shizhuozhang/17_eletricity_simu_platform-YkZ/README.md

该项目针对电力仿真实验平台设计底层信息采集电路和处理程序，然后将其发送到PC端的上位机进行不同模式的电力仿真实验。

感兴趣的同学想要进一步了解项目详情，请联系我：yaokunz@hust.edu.cn
