shizhuozhang/17_eletricity_simu_platform-YkZ/DOC/电气实验平台元件清单V2.0.xlsx

实验台元件清单
 | 元件名 | 数量 | 单价 | 备注 | 购买链接 | 总价
面板上器件 | 圆形带灯自锁按钮 | 17 | 3.2 | 灯珠额定电压12V，红色 | https://item.taobao.com/item.htm?spm=a1z09.2.0.0.2ed6e7970VER5y&id=554540313597&_u=p22lrpv0edf0 | 54.4
 | 圆形带灯自复位按钮 | 2 | 2.8 | 灯珠额定电压12V，绿色 | https://item.taobao.com/item.htm?spm=a1z09.2.0.0.2ed6e7970VER5y&id=554540569113&_u=p22lrpv05211 | 5.6
 | 桌面开关 | 1 | 16.5 | 蓝色灯 | https://item.taobao.com/item.htm?spm=a1z09.2.0.0.rZ6yvK&id=526487132607&_u=tk5ocd0355b | 16.5
 | 八档转换开关 | 1 | 24 |  | https://item.taobao.com/item.htm?id=35778651608&_u=t2dmg8j26111 | 24
 | 4位数码管显示模块 | 4 | 18 |  | https://item.taobao.com/item.htm?id=38198078596&_u=t2dmg8j26111 | 72
 | 单圈线绕电位器 | 4 | 9.9 | 2K | https://item.taobao.com/item.htm?spm=a1z0d.6639537.1997196601.68.4b6215db5HO0gG&id=548292367332 | 39.6
 | 闪光蜂鸣器 | 1 | 3.3 |  | https://item.taobao.com/item.htm?spm=a1z09.2.0.0.rZ6yvK&id=4427723937&_u=tk5ocd0a434 | 3.3
 | PCB测试环 | 1 | 5.8 | 5.8是50个的总价 | https://detail.tmall.com/item.htm?id=528363218937&cm_id=140105335569ed55e27b&abbucket=10 | 5.8 | 没找到可替代的
 | 无线鼠标键盘 | 1 | 89 | 大致选了一个 | https://detail.tmall.com/item.htm?id=527056303716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 | 89
 | WIFI模块 | 1 | 146 |  | https://item.taobao.com/item.htm?id=35679630030&ns=1&abbucket=10 | 146
 | 双组开关电源 | 1 | 42 | 5V 3A/ 12V 2A | https://item.taobao.com/item.htm?id=522984722760 | 42
 | 小型断路器 | 1 | 0 | 2P，10A | https://detail.tmall.com/item.htm?id=16148926870&ns=1&abbucket=10&skuId=3427223401384 | 0 | 不知道需不需要
 | 插座 | 1 | 19.2 | 五孔 | https://detail.tmall.com/item.htm?id=524785657239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 | 19.2
硬件电路器件， 包括：（1）电源部分，（2）电气连接端子与线材，（3）PCB焊接元件 | 红黑排线 | 1 | 1.25 | 0.5平 | https://item.taobao.com/item.htm?id=38043211218&ns=1&abbucket=10 (https://item.taobao.com/item.htm?spm=a230r.1.14.55.76bf523JzRB5x&id=38043211218&ns=1&abbucket=10) | 1.25
 | 直针XH2.54端子（一套10个） | 1 | 0.3 | 3P | https://item.taobao.com/item.htm?spm=a1z09.2.0.0.2ed6e797TqQxSN&id=35551070467&_u=p22lrpv0304e | 0.3
 | 弯针XH2.54端子（一套10个） | 4 | 0.45 | 3P | https://item.taobao.com/item.htm?spm=a1z09.2.0.0.2ed6e797TqQxSN&id=35551605817&_u=p22lrpv0c882 | 1.8
 |  | 1 | 0.6 | 4P |  | 0.6
 |  | 1 | 0.75 | 5P |  | 0.75
 |  | 1 | 1.2 | 8P |  | 1.2
 |  | 1 | 1.35 | 9P |  | 1.35
 |  | 1 | 1.8 | 12P |  | 1.8
 | CH5.08接插件（一套10个） | 1 | 5.4 | 3P | https://item.taobao.com/item.htm?spm=a1z09.2.0.0.2ed6e797TqQxSN&id=16385186135&_u=p22lrpv0aaef | 5.4
 | CH5.08连接线3条 | 1 | 1.5 | 500MM | https://item.taobao.com/item.htm?spm=a1z09.2.0.0.2ed6e797TqQxSN&id=538319533713&_u=p22lrpv03020 | 1.5
 | KF2510接插件（一套20个） | 1 | 3 | 5P | https://item.taobao.com/item.htm?spm=a1z09.2.0.0.2ed6e797TqQxSN&id=16731699371&_u=p22lrpv0a187 | 3
 | 排针（一套10个） | 1 | 2 | 黄色,红色 | https://item.taobao.com/item.htm?spm=a1z09.2.0.0.2ed6e797TqQxSN&id=41359654622&_u=p22lrpv0bc8a | 2
 | KF2EDG 5.08接线端子（一套10个） | 1 | 4 | 直针 | https://item.taobao.com/item.htm?spm=a1z10.3-c-s.w4002-15103074458.33.6f79c998DQUeKp&id=543449267090 | 4
 | XH2.54连接线（26AWG,30CM |  |  | 3P单头
 | XH2.54连接线（26AWG,40CM | 4 | 0.5 | 3P单头 | https://item.taobao.com/item.htm?spm=a1z09.2.0.0.2ed6e797TqQxSN&id=550188224405&_u=p22lrpv0087b | 2
 |  | 1 | 0.8 | 5P单头 |  | 0.8
 |  | 1 |  |  |  | 0
 |  | 4 | 2.2 | 8P双头同向 |  | 8.8
 |  | 1 | 3 | 12P双头同向 |  | 3
 | XH2.54连接线（26AWG,50CM | 1 | 1.5 | 9P单头 |  | 1.5
 | KF2510连接线 (20CM) | 1 |  | 5P双头同向
 | KF2510连接线 (40CM) | 3 | 3 | 5P双头同向 | https://item.taobao.com/item.htm?spm=a1z09.2.0.0.2ed6e797TqQxSN&id=550188224405&_u=p22lrpv0087b | 9
 | IC插座（一套10个） | 1 | 1.2 | 16P | https://item.taobao.com/item.htm?spm=a1z10.3-c-s.w4002-15103074458.25.6f79c998Q06434&id=540234155161 | 1.2
 |  | 1 | 0.5 | 8P | https://item.taobao.com/item.htm?spm=a1z10.3-c-s.w4002-15103074458.28.6f79c998Q06434&id=540234067024 | 0.5
 | 主控电路板 | 1 | 8.1 | 10块样板81（含运费25） | http://www.sz-jlc.com/consumer/index.do;jsessionid=55A6A83F0942F5DDA84336B988B8CC49?s=1480256400475 | 8.1
 | 外围器件接口电路板 | 1 | 10.7 | 10块样板107（含运费17） |  | 10.7
 | MINI-USB数据线 | 1 | 3.5 | USB公头转MINI公头 | https://detail.tmall.com/item.htm?id=19648206353&rn=a4a52827b535e203981fcef212ce10ca&abbucket=6 | 3.5
 | MINI-USB插头 | 1 | 0.375 |  | https://detail.tmall.com/item.htm?id=18403110644&rn=a4a52827b535e203981fcef212ce10ca&abbucket=6 | 0.375
 | STM32F103RCT6芯片 | 1 | 19.6 | LQFT-64封装 | https://item.taobao.com/item.htm?spm=a1z09.2.0.0.2ed6e797TqQxSN&id=523892305756&_u=p22lrpv0c967 | 19.6
 | TLC5615，10位数模转换芯片 | 4 | 5 | DIP封装 | https://detail.tmall.com/item.htm?id=25890496045&spm=a1z09.2.0.0.2ed6e797TqQxSN&_u=p22lrpv099e3 | 20
 | 74HC165芯片 | 4 | 0.95 | DIP封装 | https://detail.tmall.com/item.htm?id=39693581268&spm=a1z09.2.0.0.2ed6e797TqQxSN&_u=p22lrpv0381c | 3.8
 | LM358双路运放 | 2 | 1 | DIP封装 | http://www.szlcsc.com/product/details_5634.html | 2
 | CH340C芯片 | 1 | 2.02 | SOP16封装 | http://www.szlcsc.com/product/details_85852.html | 2.02
 | P785光耦 | 1 | 0.42 | DIP封装 | https://item.taobao.com/item.htm?id=522578352711&ns=1&abbucket=10 (https://item.taobao.com/item.htm?spm=a230r.1.14.48.76bf523YAApDt&id=522578352711&ns=1&abbucket=10) | 0.42
 | AMS1117-3.3稳压芯片 | 4 | 0.7 | SOT-223封装 | http://www.szlcsc.com/product/details_6652.html | 2.8
 | HK19F-DC5V八脚继电器 | 1 | 2 |  | https://item.taobao.com/item.htm?spm=a1z09.2.0.0.2ed6e797TqQxSN&id=524178551384&_u=p22lrpv0a368 | 2
 | 直插无源石英晶振8M | 1 | 0.2 |  | https://detail.tmall.com/item.htm?id=25022680758&spm=a1z09.2.0.0.2ed6e797TqQxSN&_u=p22lrpv0e6fc | 0.2
 | 直插无源石英晶振12M | 1 | 0.2 |  |  | 0.2
 | 四脚贴片按键 | 1 | 0.07 |  | https://detail.tmall.com/item.htm?id=22247079909&rn=c54d9132209704ca52bad2cfbac3d2ca&abbucket=6 | 0.07
 | 自恢复保险丝8V/2.6A | 3 | 0.3 |  | https://detail.tmall.com/item.htm?id=18419209233&spm=a1z09.2.0.0.2ed6e797TqQxSN&_u=p22lrpv0dc97 | 0.9
 | 自恢复保险丝6V/0.5A | 2 | 0.24 |  | https://detail.tmall.com/item.htm?id=25039188105&spm=a1z09.2.0.0.2ed6e797xzGEqp&_u=p22lrpv0478b | 0.48
 | 贴片稳压二极管MM3Z3V3 | 30 | 0.06 |  | https://detail.tmall.com/item.htm?id=21781315853&spm=a1z09.2.0.0.2ed6e797TqQxSN&_u=p22lrpv03b83 | 1.8
 | TVS静电保护二极管3.3V | 3 | 0.15 |  | https://detail.tmall.com/item.htm?id=18423545093&spm=a1z09.2.0.0.2ed6e797xzGEqp&_u=p22lrpv02898 | 0.45
 | 贴片三极管S8050 | 1 | 0.35 |  | https://item.taobao.com/item.htm?spm=a1z10.3-c-s.w4002-16569462289.11.6f79c998pNWokU&id=522577964105 | 0.35
 | 贴片电感10UH | 2 | 0.05 |  | https://detail.tmall.com/item.htm?id=37616915845&spm=a1z09.2.0.0.2ed6e797xzGEqp&_u=p22lrpv05aca | 0.1
 | 贴片LED灯 | 2 | 0.03 | 0603封装，颜色自选 | https://item.taobao.com/item.htm?spm=a1z09.2.0.0.2ed6e7970VER5y&id=522573257623&_u=p22lrpv0bac5 | 0.06
 | 贴片LED灯 | 8 | 0.06 | 0805封装，颜色自选 | https://item.taobao.com/item.htm?spm=a1z09.2.0.0.2ed6e797xzGEqp&id=522572714856&_u=p22lrpv0e9ce | 0.48
 | 贴片电阻1206封装 | 60 | 0.0155 | 阻值200R | http://www.szlcsc.com/product/details_18690.html | 0.93
 | 贴片电阻0805/0603封装 | 50 | 0.01 | 阻值0R，470R,1K,2.2K,4.7K,10K等 | http://www.szlcsc.com/so/search/global.html&global_search_keyword=%25E8%25B4%25B4%25E7%2589%2587%25E7%2594%25B5%25E9%2598%25BB0805&global_current_catalog=&sea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 | 0.5
 | 贴片排阻0603封装 | 100 | 0.0164 | 阻值3.9K | http://www.szlcsc.com/product/details_12569.html | 1.64
 | 电解电容330UF/16V | 1 | 0.095 |  | http://www.szlcsc.com/product/details_44810.html | 0.095
 | 电解电容100UF/35V | 1 | 0.17 |  | http://www.szlcsc.com/product/details_60372.html | 0.17
 | 贴片电容0.1UF | 50 | 0.01 | 0603封装 | http://www.szlcsc.com/product/details_91995.html | 0.5
 | 贴片电容2.2UF | 5 | 0.084 | 0805封装 | http://www.szlcsc.com/product/details_50225.html | 0.42
 | 贴片电容10UF | 10 | 0.144 | 1206封装 | http://www.szlcsc.com/product/details_40110.html | 1.44
 |  | 5 | 0.087 | 0805封装 | http://www.szlcsc.com/product/details_90369.html | 0.435
其他 | 3D打印耗材 | 0.5 | 36.5 | 黑色 | https://item.taobao.com/item.htm?spm=a1z09.2.0.0.2ed6e7970VER5y&id=524122622388&_u=p22lrpv0d641 | 18.25
 | 尼龙六角螺母M3（10只一套） | 1 | 0.5 |  | https://item.taobao.com/item.htm?spm=a1z09.2.0.0.2ed6e797xzGEqp&id=528265478708&_u=p22lrpv0ade6 | 0.5
 | 沉头十字尼龙螺丝M3（10只一套） | 1 | 0.8 |  | https://item.taobao.com/item.htm?spm=a1z09.2.0.0.2ed6e797xzGEqp&id=528197207984&_u=p22lrpv09dc5 | 0.8
 | 尼龙柱M3(10只一套) | 2 | 1.5 | 8MM,15MM | https://item.taobao.com/item.htm?spm=a1z09.2.0.0.2ed6e797xzGEqp&id=535441034110&_u=p22lrpv0f71e | 3
备注:（1）此清单中元件主要包含硬件电路及其外围方面的器件，零散杂件未包含其中；（2）元件数量是一台实验台所需数量,端子类器件和阻容元件部分有余量；（3）购买链接可供参考；（4）单价仅供参考，商品价格会有波动；（5）编辑日期截止到2017年9月23日，如有必要，请及时更新 |  |  |  |  |  | 678.235
