shizhuozhang/17_eletricity_simu_platform-YkZ/Crust_3D/BOX_WIFI.SLDPRT

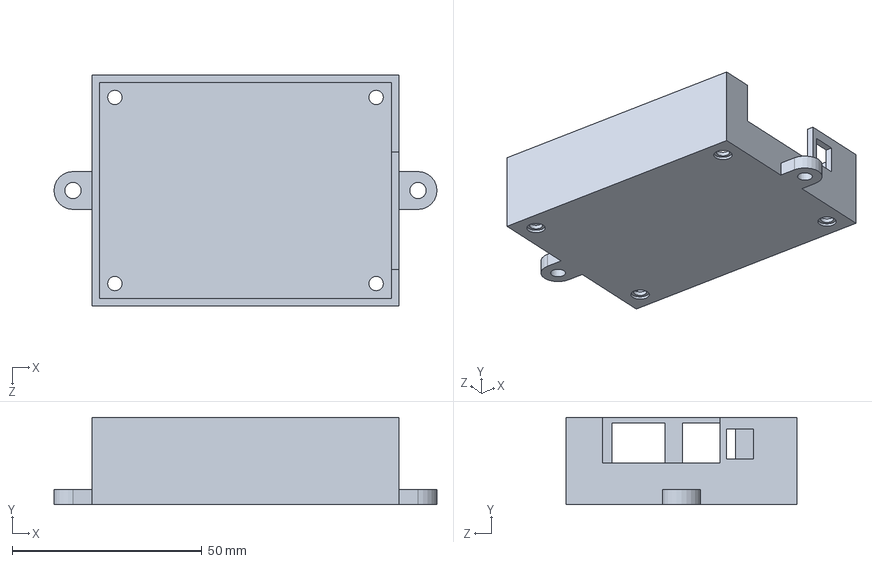
[picture p3: CAD file, 2021-10-20]
Crust_3D/BOX_WIFI.SLDPRT
101.0 x 23.0 x 61.0 mm
