shizhuozhang/17_eletricity_simu_platform-YkZ/Crust_3D/BOX_INTERFACE_V3.SLDPRT

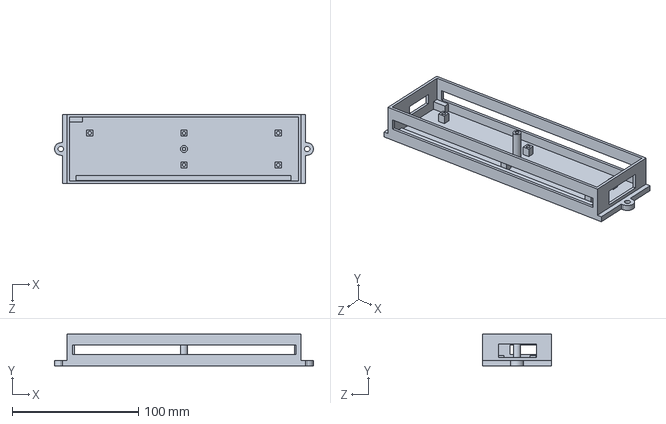
[picture p4: CAD file, 2021-10-20]
Crust_3D/BOX_INTERFACE_V3.SLDPRT
205.0 x 25.0 x 55.0 mm
