shizhuozhang/17_eletricity_simu_platform-YkZ/Crust_3D/INTERFACE_COVERV2.SLDPRT

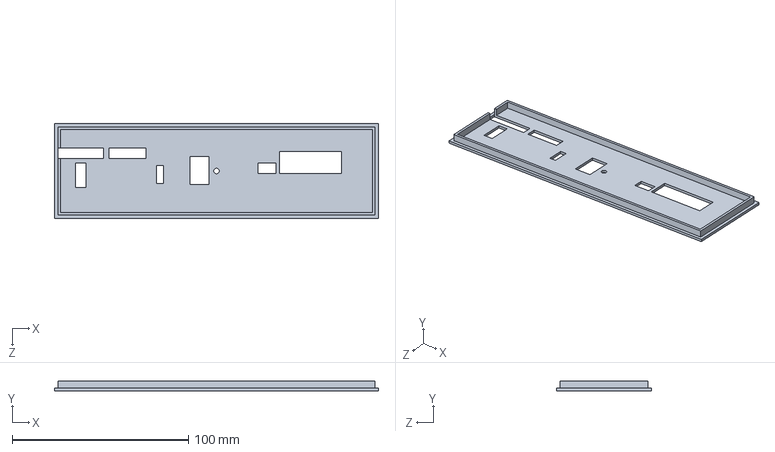
[picture p5: CAD file, 2021-10-20]
Crust_3D/INTERFACE_COVERV2.SLDPRT
183.8 x 5.50 x 53.8 mm
