shizhuozhang/17_eletricity_simu_platform-YkZ/Crust_3D/WIFI_COVER.SLDPRT

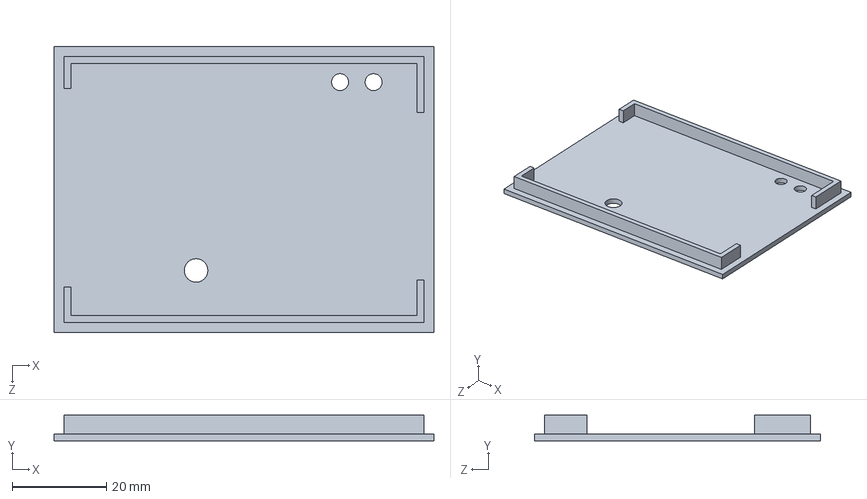
[picture p6: CAD file, 2021-10-20]
Crust_3D/WIFI_COVER.SLDPRT
80.5 x 5.50 x 60.5 mm
