shizhuozhang/17_eletricity_simu_platform-YkZ/Crust_3D/BOX_CONTROL_COVER.SLDPRT

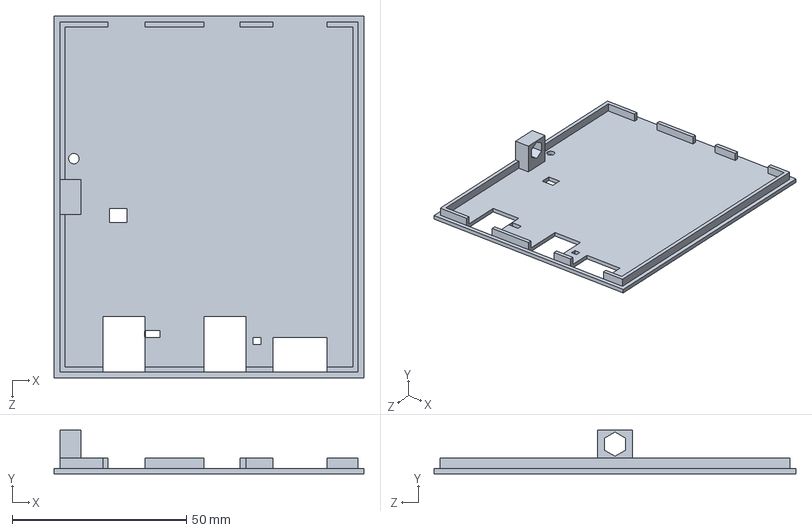
[picture p7: CAD file, 2021-10-20]
Crust_3D/BOX_CONTROL_COVER.SLDPRT
88.8 x 12.5 x 103.8 mm
