shizhuozhang/17_eletricity_simu_platform-YkZ/Crust_3D/BOX_CONTROL.SLDPRT

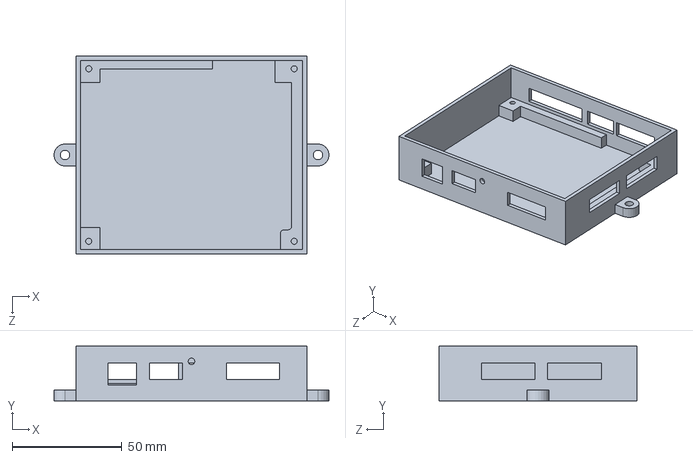
[picture p8: CAD file, 2021-10-20]
Crust_3D/BOX_CONTROL.SLDPRT
125.0 x 25.0 x 90.0 mm
