shizhuozhang/17_eletricity_simu_platform-YkZ/PCB/控制板/INF_Pro_Interface.pdf

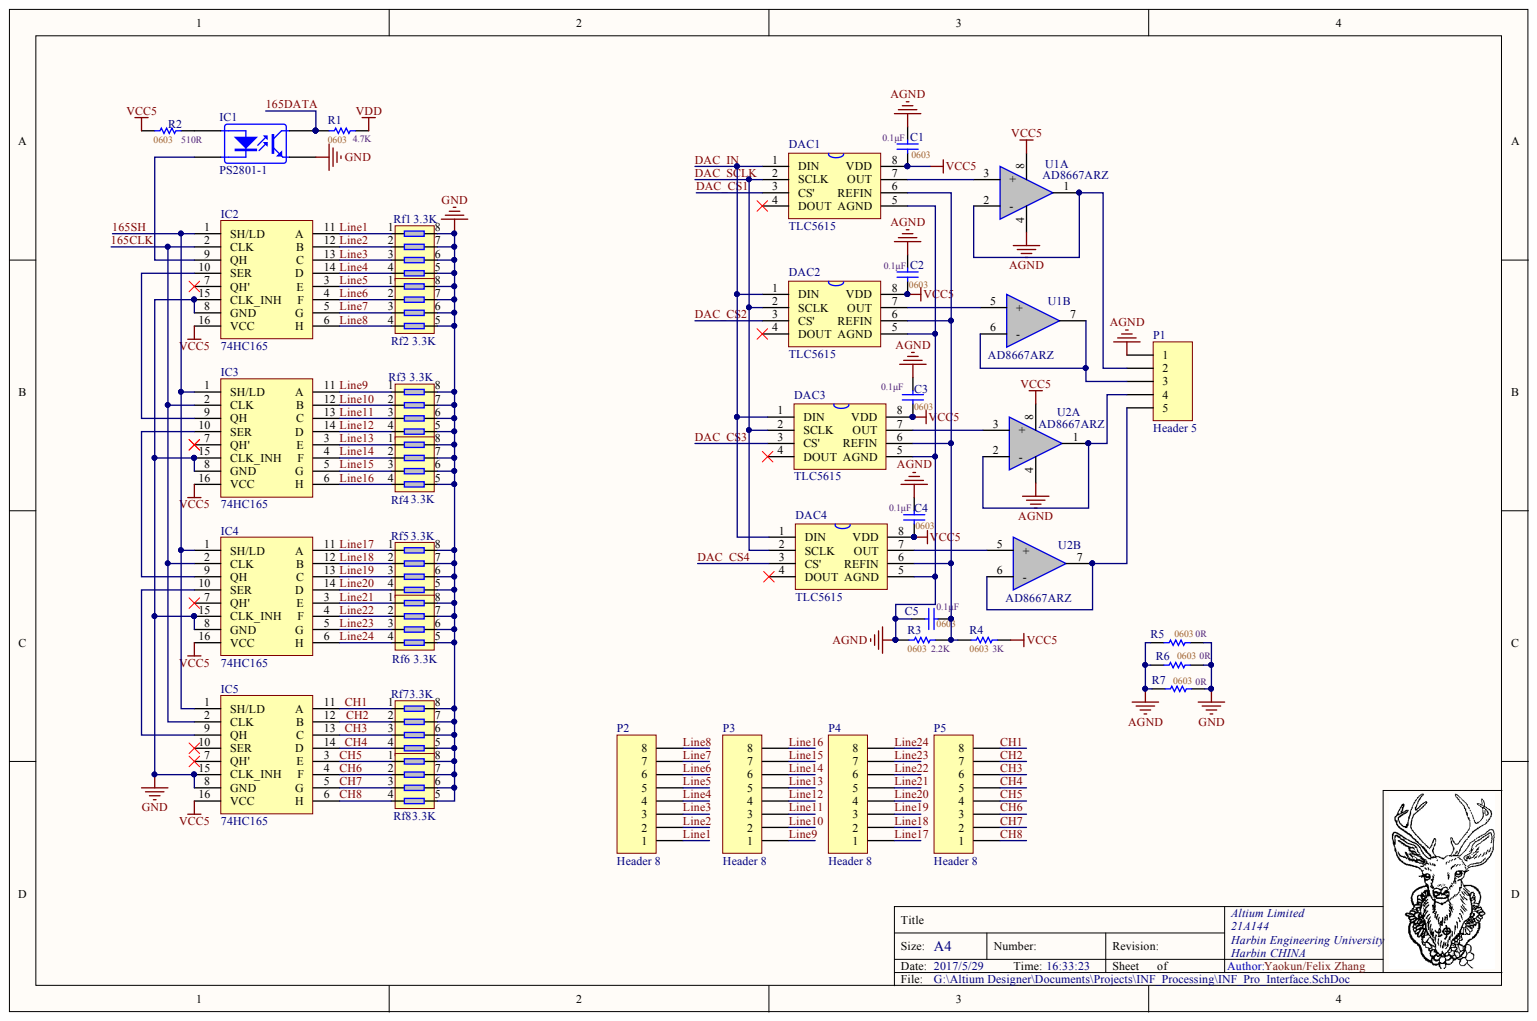
[picture p9: page 1]

SER 10 QH 9

GND 8

Line19 | CH6
Line18 | CH7
Line17 | CH8

Title | Altium Limited 21A144 Harbin Engineering University Harbin CHINA

Size: A4 | Number: | Revision:
Date: 2017/5/29 Time: 16:33:23 | Sheet of | Author:Yaokun/Felix Zhang

G:\Altium Designer\Documents\Projects\INF_Processing\INF_Pro_Interface.SchDoc
File:
