shizhuozhang/17_eletricity_simu_platform-YkZ/PCB/接口板/Interfaces.pdf

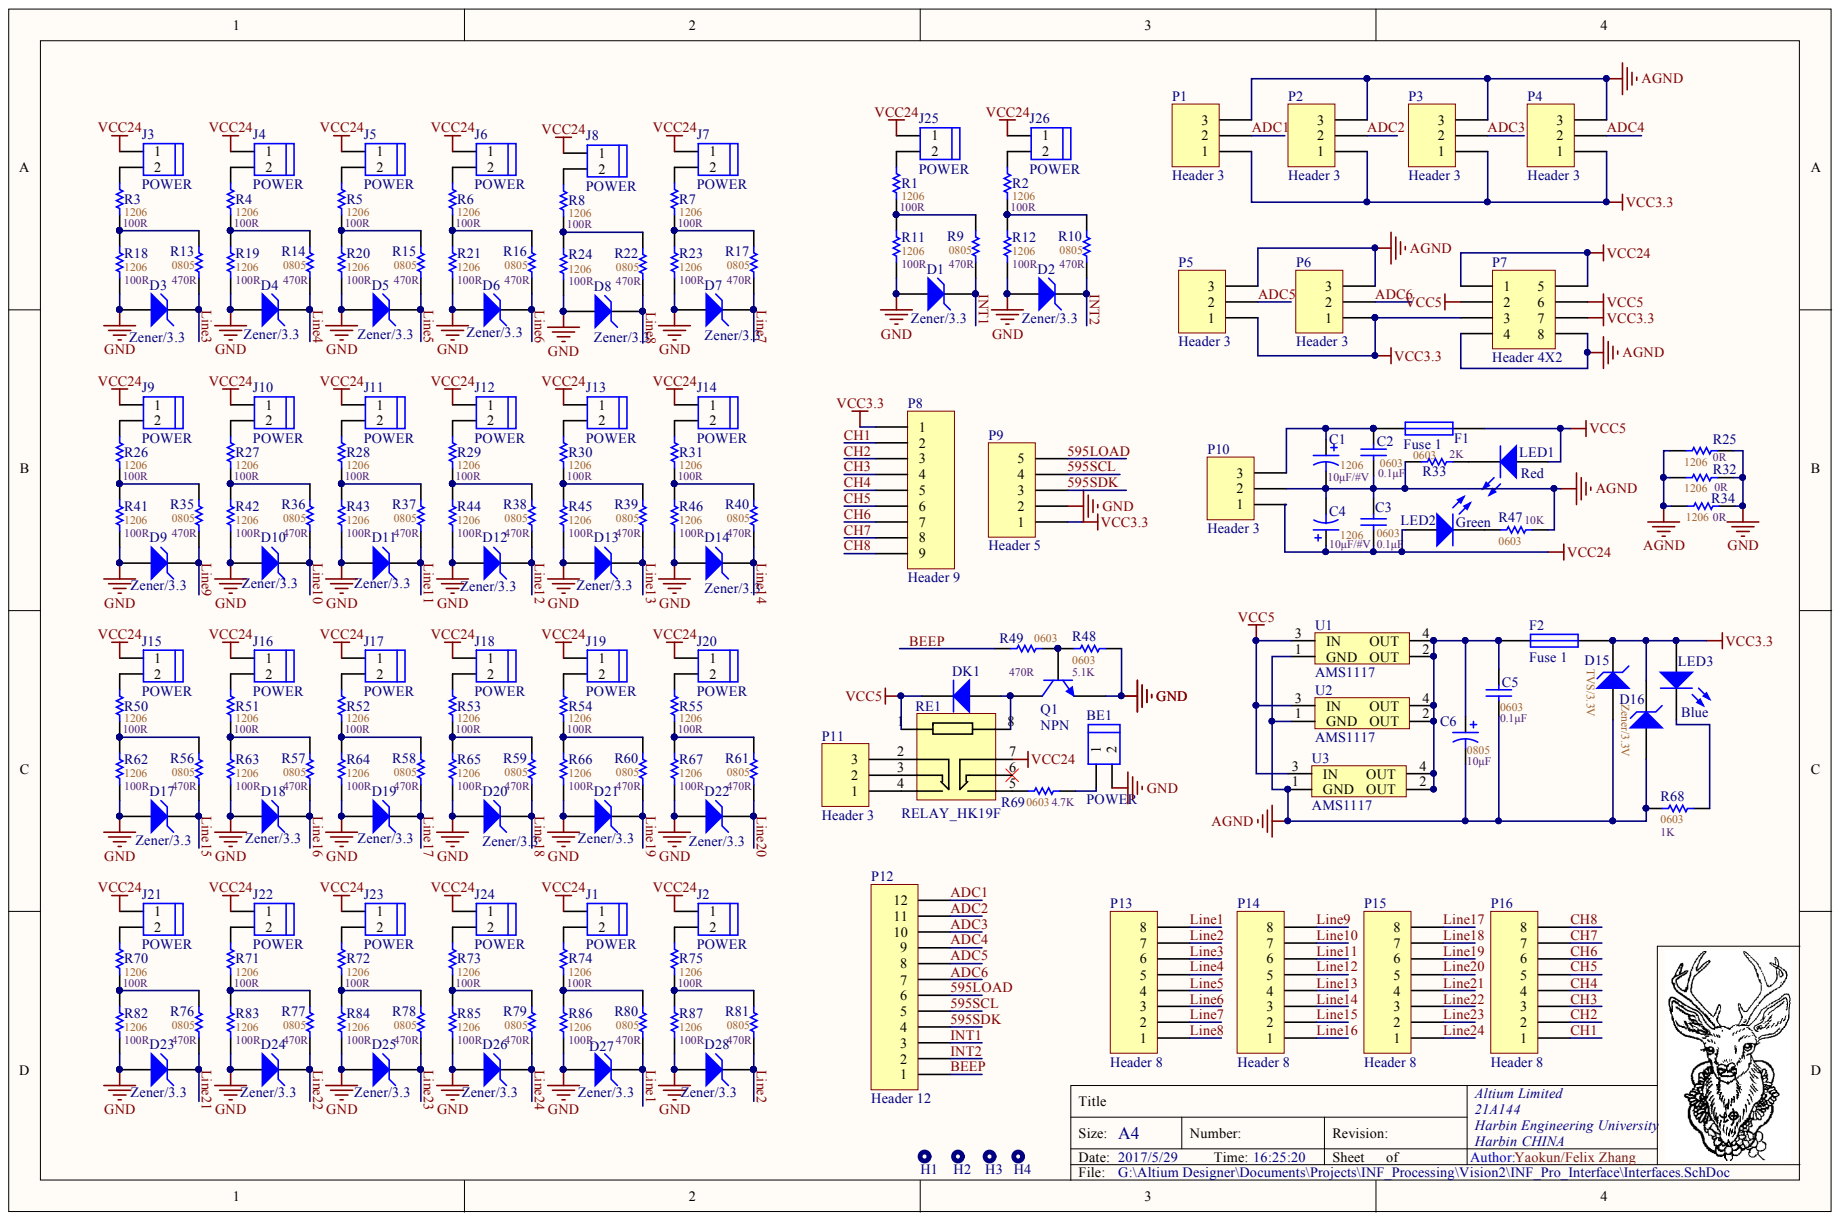
[picture p10: page 1]

Title | Altium Limited 21A144 Harbin Engineering University Harbin CHINA

Size: A4 | Number: | Revision:
Date: 2017/5/29 Time: 16:25:20 | Sheet of | Author:Yaokun/Felix Zhang

G:\Altium Designer\Documents\Projects\INF_Processing\Vision2\INF_Pro_Interface\Interfaces.SchDoc
File:
