shizhuozhang/17_eletricity_simu_platform-YkZ/PCB/控制板/INF_Processing.pdf

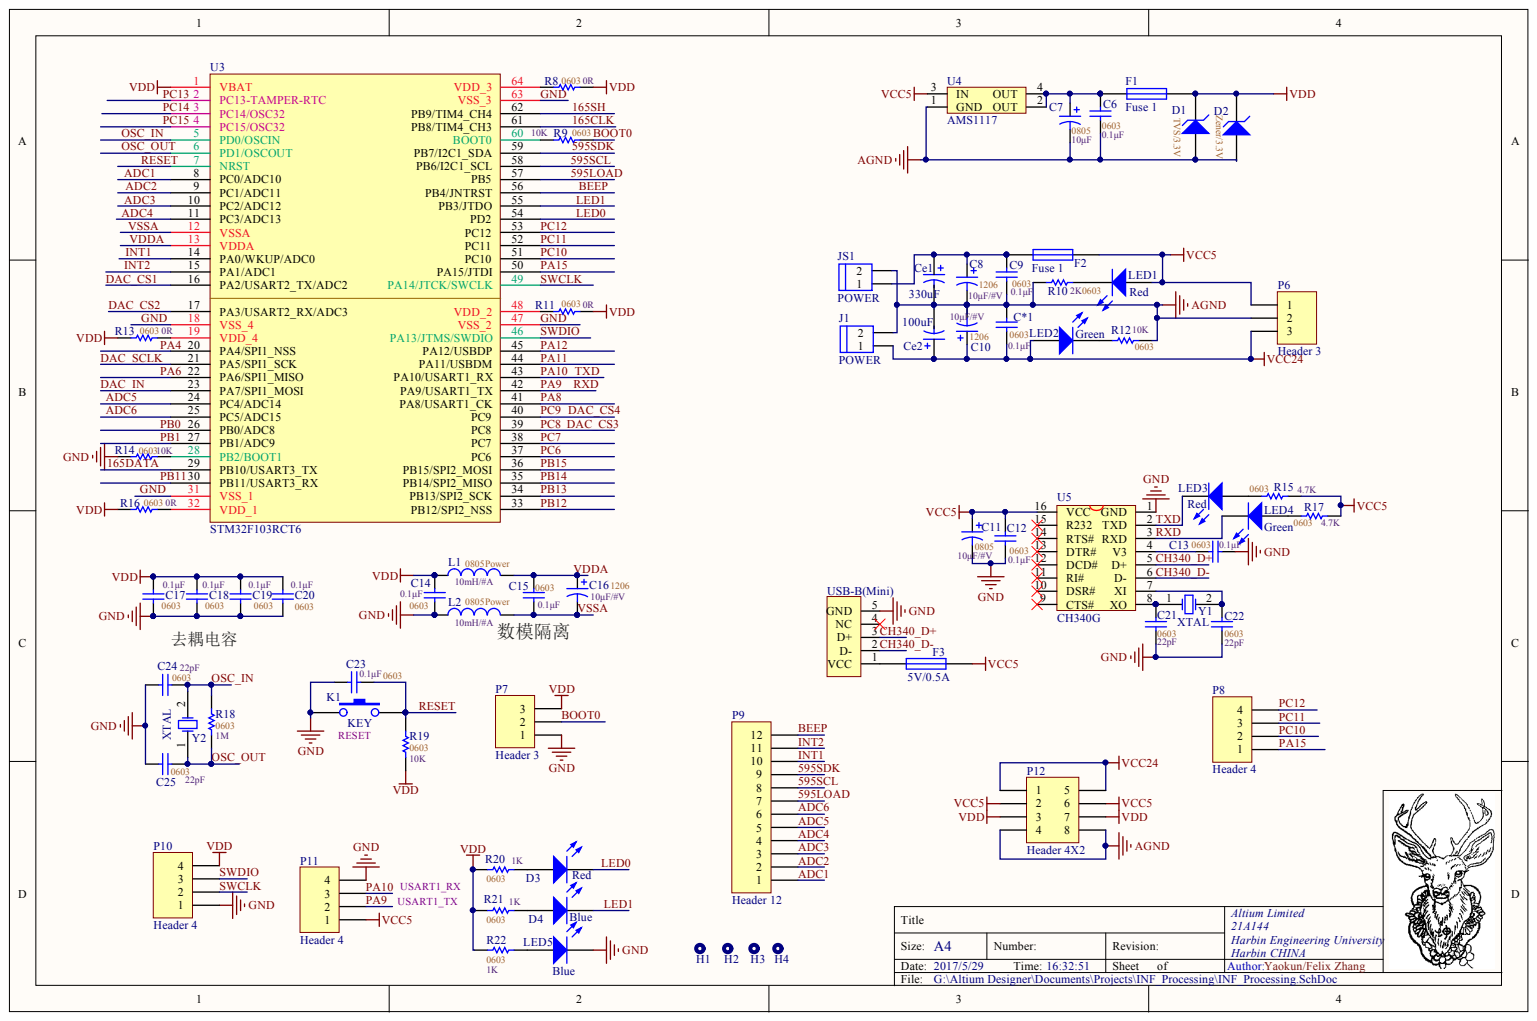
[picture p11: page 1]

Title | Altium Limited 21A144 Harbin Engineering University Harbin CHINA

Size: A4 | Number: | Revision:
Date: 2017/5/29 Time: 16:32:51 | Sheet of | Author:Yaokun/Felix Zhang

G:\Altium Designer\Documents\Projects\INF_Processing\INF_Processing.SchDoc
File:
