shizhuozhang/17_eletricity_simu_platform-YkZ/(list of files, drawings)

Other design files:
PCB/接口板/INF_Pro_Interface.PrjPcb
PCB/接口板/Interfaces.SchDoc
PCB/控制板/INF_Pro_Interface.SchDoc
PCB/控制板/INF_Processing.PrjPcb
PCB/控制板/INF_Processing.SchDoc
