shizhuozhang/17_eletricity_simu_platform-YkZ/code/SYSTEM/usart/usart.h

#ifndef __USART_H
#define __USART_H
#include "stdio.h"	
#include "sys.h"
#include "HC165.h"
#include "IO.h"
#include "malloc.h"	
#include "adc.h"

/***************REFER TO ALIENTEK*******************/

////////////////////////////////////////////////////////////////////////////////// 	
//#define USART_REC_LEN  			200  	//定义最大接收字节数 200
//#define EN_USART1_RX 			1		//使能（1）/禁止（0）串口1接收
	  	
//extern u8  USART_RX_BUF[USART_REC_LEN]; //接收缓冲,最大USART_REC_LEN个字节.末字节为换行符 
//extern u16 USART_RX_STA;         		//接收状态标记	
//如果想串口中断接收，请不要注释以下宏定义

__align(1) union FromUp
{
	u16 Data16_bits;
	u8  Data8_bits[2];
};


void uart_init(u32 bound);
void Print(void);
void Update_Dac(void);
void Uart1_PutChar(u8 ch);
#endif
